CodeForAfrica/sensors.AFRICA-AQ-sensors-hardware-GSM/src/AQ_sensor_GSM.brd

## EAGLE design src/AQ_sensor_GSM.brd (2023-09-25)

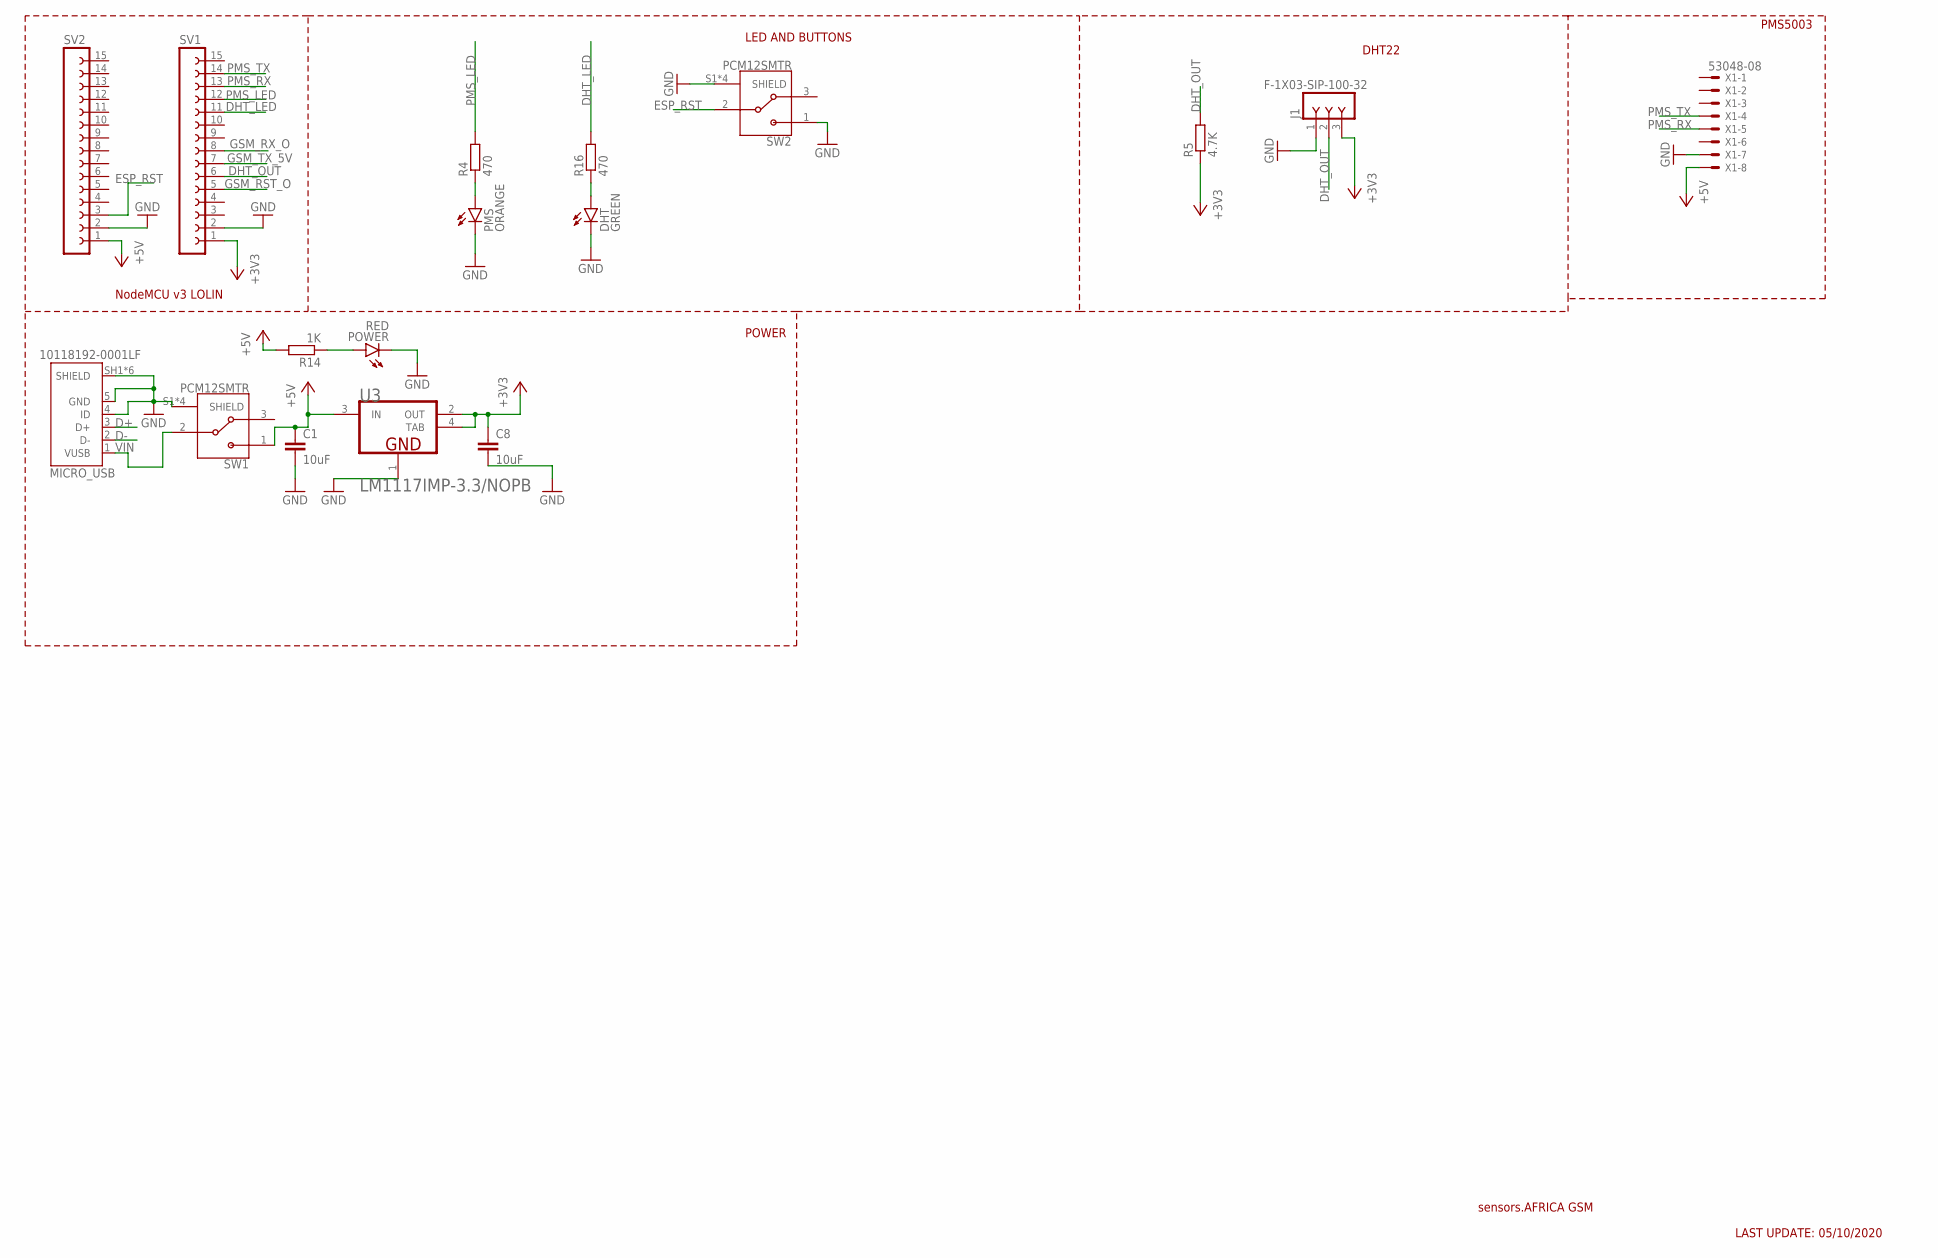
[picture p1: schematic AQ_sensor_GSM.sch, sheet 1]

Parts:
C1, C8: 10uF; C0603
DHT: GREEN; CHIP-LED0603
J1: F-1X03-SIP-100-32; SIP-100-03-32
MICRO_USB: 10118192-0001LF; AMPHENOL_10118192-0001LF
PMS: ORANGE; CHIP-LED0603
POWER: RED; CHIP-LED0603
R4, R16: 470; R0603
R5: 4.7K; R0603
R14: 1K; R0603
SV1, SV2: FE15-1; FE15
SW1, SW2: PCM12SMTR; SW_PCM12SMTR
U3: TEXAS_INSTRUMENTS_LM1117IMP-3.3-NOPBTEXAS_INSTRUM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; TEXAS_INSTRUMENTS_LM1117IMP-3.3-NOPB_0
X1: 53048-08

Connections:
+3V3: C8.1, J1.3, R5.1, SV1.1, U3.2 (OUT), U3.4 (TAB)
+5V: C1.1, R14.2, SV2.1, SW1.1, U3.3 (IN), X1.8; also elsewhere on the board
D+: MICRO_USB.3 (D+)
D-: MICRO_USB.2 (D-)
DHT_LED: R16.2, SV1.11
DHT_OUT: J1.2, R5.2, SV1.6
ESP_RST: SV2.3, SW2.2
GND: C1.2, C8.2, DHT.C, J1.1, MICRO_USB.4 (ID), MICRO_USB.5 (GND), MICRO_USB.SH1 (SHIELD), MICRO_USB.SH2 (SHIELD), MICRO_USB.SH3 (SHIELD), MICRO_USB.SH4 (SHIELD), MICRO_USB.SH5 (SHIELD), MICRO_USB.SH6 (SHIELD), PMS.C, POWER.C, SV1.2, SV2.2, SW1.S1 (SHIELD), SW1.S2 (SHIELD), SW1.S3 (SHIELD), SW1.S4 (SHIELD), SW2.1, SW2.S1 (SHIELD), SW2.S2 (SHIELD), SW2.S3 (SHIELD), SW2.S4 (SHIELD), U3.1 (GND), X1.7; also elsewhere on the board
GSM_RST_O: SV1.5
GSM_RX_O: SV1.8; also elsewhere on the board
GSM_TX_5V: SV1.7; also elsewhere on the board
unnamed: PMS.A, R4.1
unnamed: POWER.A, R14.1
unnamed: DHT.A, R16.1
PMS_LED: R4.2, SV1.12
PMS_RX: SV1.13, X1.5
PMS_TX: SV1.14, X1.4
VIN: MICRO_USB.1 (VUSB), SW1.2

Notes on the sheet:
sensors.AFRICA GSM
LAST UPDATE: 05/10/2020
LED AND BUTTONS
PMS5003
DHT22
NodeMCU v3 LOLIN
POWER

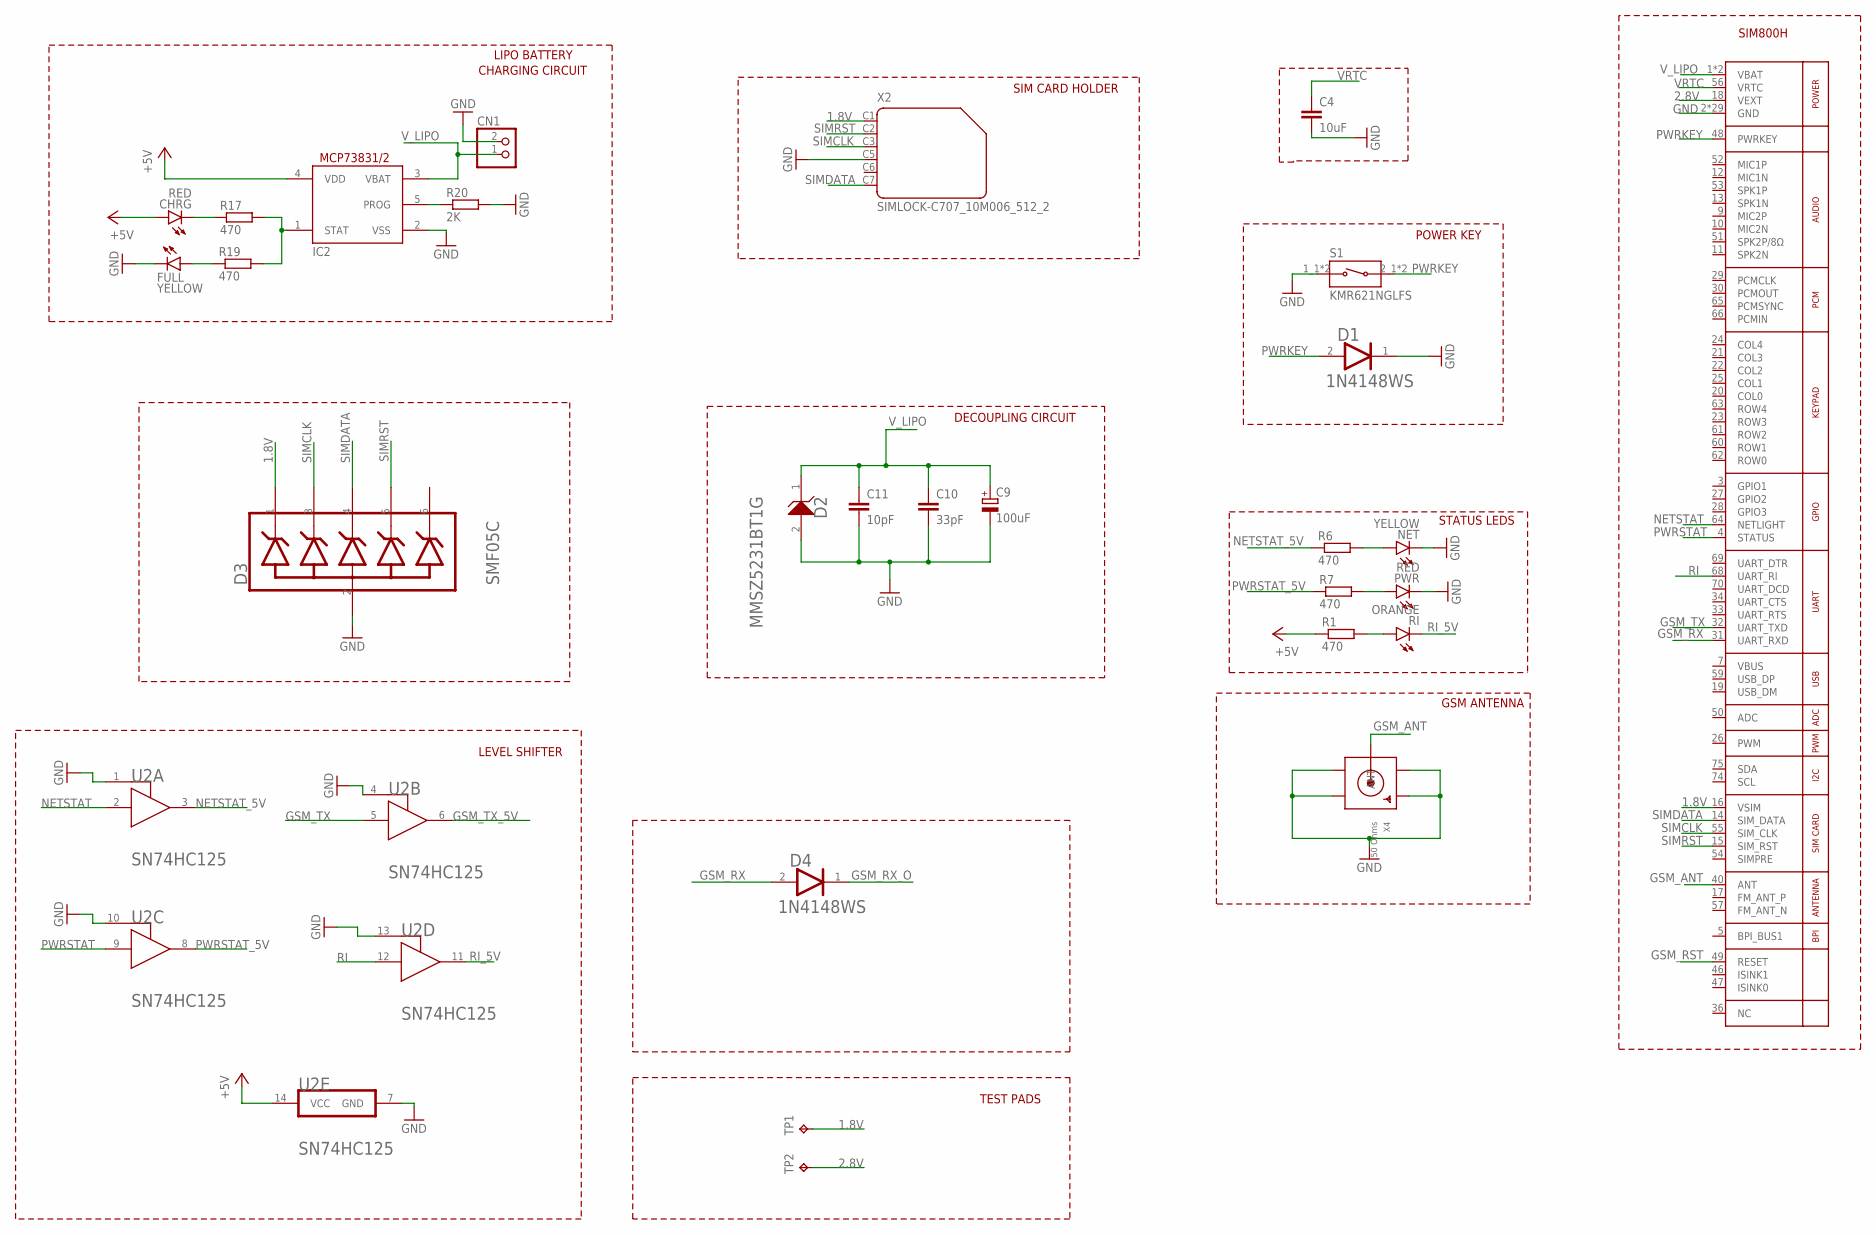
[picture p2: schematic AQ_sensor_GSM.sch, sheet 2]

Parts:
C4: 10uF; C0603
C9: 100uF; PANASONIC_D
C10: 33pF; C0603
C11: 10pF; C0603
CHRG: RED; CHIP-LED0603
CN1: JST_2PIN-SMT-RA; JST-PH-2-SMT-RA
D1, D4: ON_SEMI_1N4148WSON_SEMI_1N4148WS_0_0; ON_SEMI_1N4148WS_0
D2: ON_SEMICONDUCTOR_MMSZ5231BT1GON_SEMICONDUCTOR_MMS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; ON_SEMICONDUCTOR_MMSZ5231BT1G_0
D3: SEMTECH_SMF05CSEMTECH_SMF05C_0_0; SEMTECH_SMF05C_0
FULL: YELLOW; CHIP-LED0603
IC2: MCP73831/OT; SOT23-5L
NET: YELLOW; CHIP-LED0603
PWR: RED; CHIP-LED0603
R1, R6, R7, R17, R19: 470; R0603
R20: 2K; R0603
RI: ORANGE; CHIP-LED0603
S1: KMR621NGLFS; SW_KMR621NGLFS
TP1, TP2: TPB1,27; B1,27
U1: GSM_SIM800L; SIM800L
U2: TEXAS_INSTRUMENTS_SN74HC125TEXAS_INSTRUMENTS_SN74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; TEXAS_INSTRUMENTS_SN74HC125_0
X2: SIMLOCK-C707_10M006_512_2; C707_10M006_512_2
X4: 50 Ohms; SMA_EDGELAUNCH_UFL

Connections:
1.8V: D3.1 (1_CATHODE), TP1.TP, U1.16 (VSIM), X2.C1 (1)
2.8V: TP2.TP, U1.18 (VEXT)
+5V: CHRG.A, IC2.4 (VDD), R1.1, U2.14 (VCC); also elsewhere on the board
GND: C4.2, C9.-, C10.2, C11.2, CN1.2 (1), D1.1 (CATHODE), D2.2 (A), D3.2 (ANODE), FULL.C, IC2.2 (VSS), NET.C, PWR.C, R20.2, S1.1_1 (1), S1.1_2 (1), U1.2 (GND), U1.6 (GND), U1.8 (GND), U1.35 (GND), U1.37 (GND), U1.38 (GND), U1.39 (GND), U1.41 (GND), U1.43 (GND), U1.44 (GND), U1.45 (GND), U1.58 (GND), U1.67 (GND), U1.71 (GND), U1.72 (GND), U1.73 (GND), U1.76 (GND), U1.77 (GND), U1.78 (GND), U1.79 (GND), U1.80 (GND), U1.81 (GND), U1.82 (GND), U1.83 (GND), U1.84 (GND), U1.85 (GND), U1.86 (GND), U1.87 (GND), U1.88 (GND), U2.1 (1_!OE!), U2.4 (4_!OE!), U2.7 (GND), U2.10 (2_!OE!), U2.13 (3_!OE!), X2.C5 (4), X4.GND@1 (GND1), X4.GND@2 (GND2), X4.GND@3 (GND3), X4.GND@4 (GND4); also elsewhere on the board
GSM_ANT: U1.40 (ANT), X4.P (ANT)
GSM_RST: U1.49 (RESET)
GSM_RX: D4.2 (ANODE), U1.31 (UART_RXD)
GSM_RX_O: D4.1 (CATHODE); also elsewhere on the board
GSM_TX: U1.32 (UART_TXD), U2.5 (2A)
GSM_TX_5V: U2.6 (2Y); also elsewhere on the board
unnamed: CHRG.C, R17.1
unnamed: IC2.1 (STAT), R17.2, R19.2
unnamed: NET.A, R6.2
unnamed: PWR.A, R7.2
unnamed: FULL.A, R19.1
unnamed: IC2.5 (PROG), R20.1
unnamed: R1.2, RI.A
NETSTAT: U1.64 (NETLIGHT), U2.2 (1A)
NETSTAT_5V: R6.1, U2.3 (1Y)
PWRKEY: D1.2 (ANODE), S1.2_1 (2), S1.2_2 (2), U1.48 (PWRKEY)
PWRSTAT: U1.4 (STATUS), U2.9 (3A)
PWRSTAT_5V: R7.1, U2.8 (3Y)
RI: U1.68 (UART_RI), U2.12 (4A)
RI_5V: RI.C, U2.11 (4Y)
SIMCLK: D3.3 (2_CATHODE), U1.55 (SIM_CLK), X2.C3 (3)
SIMDATA: D3.4 (3_CATHODE), U1.14 (SIM_DATA), X2.C7 (6)
SIMRST: D3.5 (4_CATHODE), U1.15 (SIM_RST), X2.C2 (2)
VBUS: U1.7 (VBUS)
VRTC: C4.1, U1.56 (VRTC)
V_LIPO: C9.+, C10.1, C11.1, CN1.1 (2), D2.1 (K), IC2.3 (VBAT), U1.1 (VBAT), U1.42 (VBAT)

Notes on the sheet:
SIM800H
POWER KEY
STATUS LEDS
SIM CARD HOLDER
CHARGING CIRCUIT
LIPO BATTERY
GSM ANTENNA
TEST PADS
LEVEL SHIFTER
DECOUPLING CIRCUIT

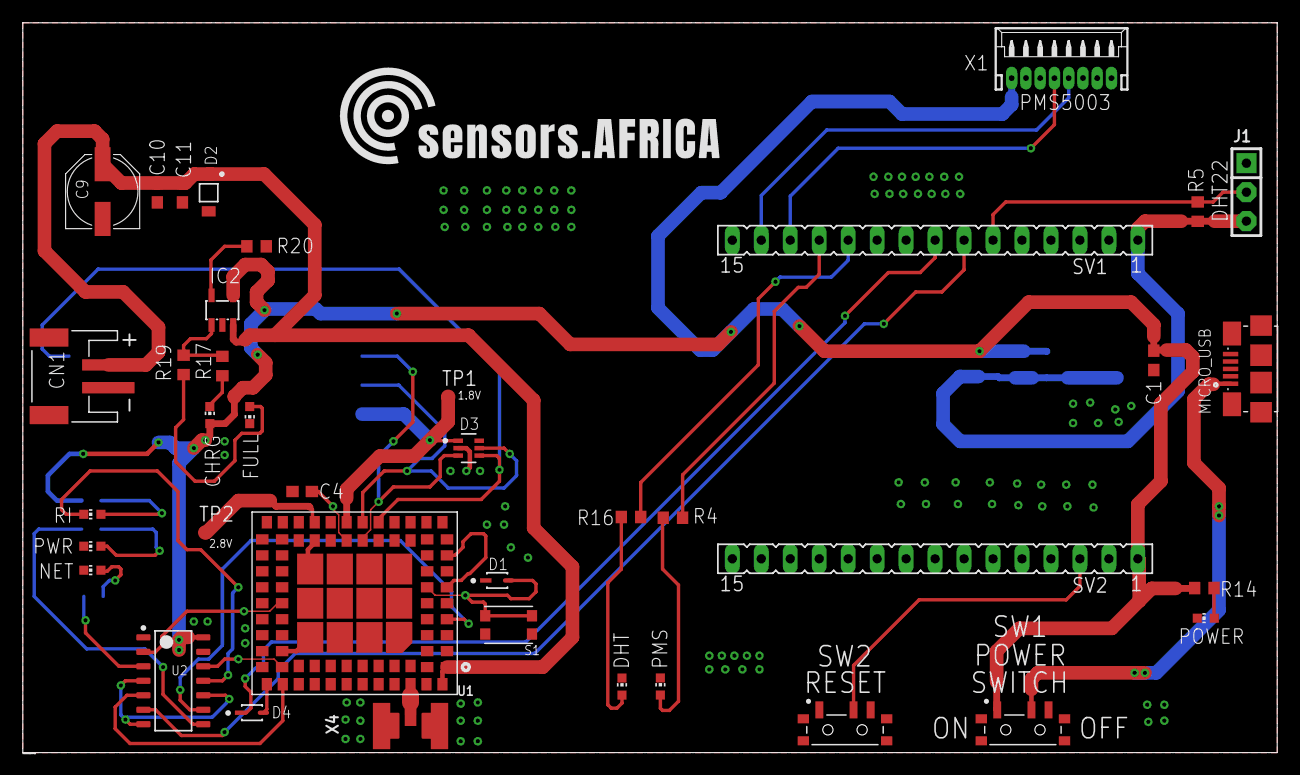
[picture p3: board AQ_sensor_GSM.brd from above]

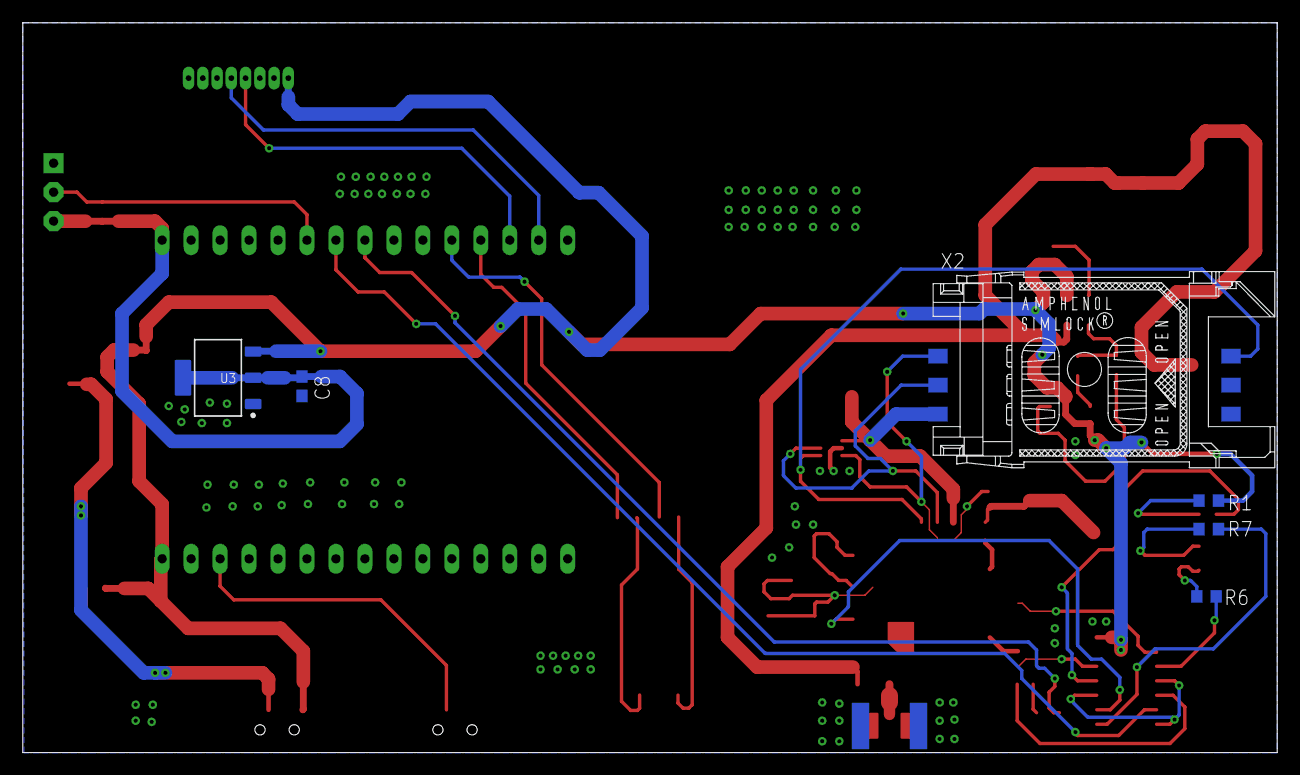
[picture p4: board AQ_sensor_GSM.brd from below]

Board: 2 copper layers, 110.0 x 64.0 mm, 45 parts (6 on the bottom side), 39 nets.
