CodeForAfrica/sensors.AFRICA-AQ-sensors-hardware-GSM/(threads)

Thread 2 (2023-09-13):

Compare main branch with fix/swap-dht-pms-locations branch

gideonmaina, 2023-09-13:
[REF ORDER](https://circuithub.com/project-orders/sensors.AFRICA/000ea94e)
fix/swap-dht-pms-locations branch was used for the first version of the AQ enclosure.

augustinemwendwa72, 2023-09-15:
[Comparison between main and fix/swap-dht-pms-locations github branches](https://github.com/CodeForAfrica/sensors.AFRICA-AQ-sensors-hardware-GSM/issues/2)

The Following are the findings on reviewing the designs contained in the above mentioned GitHub branches:

- The two branches contain similar files, similar design schematics and PCB designs. The images attached show these similarities.
- Both designs were not used to print currently used AQ sensor boards, since all do have mounting holes on the PCB unlike the designs in these git  branches.

**feature/generate_manufacturing_files**
PCB Layout
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
**Top View**
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
**Bottom View**
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

Git Branch Branch: [main](url)
**PCB Layout**
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

Top View
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

Bottom View
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

gideonmaina, 2023-09-15:
@augustinemwendwa72 reminder that the branch of interest is **fix/swap-dht-pms-locations-branch**.  Changing the title of the issue is misleading as it is not what this issue is about.

P.S. There was already a [PR on **feature/generate_manufacturing_files**](https://github.com/CodeForAfrica/sensors.AFRICA-AQ-sensors-hardware-GSM/pull/1) branch and was subsequently deleted.

gideonmaina, 2023-09-15:
I will restore the title @augustinemwendwa72 . You can delete the comment associated with the generate_manufacturing_files branch and proceed with this issue's topic.

augustinemwendwa72, 2023-09-19:
[Comparison between main and fix/swap-dht-pms-locations github branches](https://github.com/CodeForAfrica/sensors.AFRICA-AQ-sensors-hardware-GSM/issues/2)

The Following are the findings on reviewing the designs contained in the above mentioned GitHub branches:

- The fix/swap-dht-pms-locations branch is the updated version of the main branch.
- The PCB layout on the main branch does not have mounting holes.
- The PCB layout on the fix/swap-dht-pms-locations branch has mounting holes.
- The PCB files sent to [www.circuithub.com](https://circuithub-static1.s3.amazonaws.com/orders/11245/attachments/LTximzySSLej1t2K4i03_Image%20from%20iOS%28861%29.jpg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) for manufacturing match those on the fix/swap-dht-pms-locations.
- I suggest a merge with the main, considering fix/swap-dht-pms-locations is the most updated version of the main branch.

**AQ Board sent to [www.circuithub.com](https://circuithub-static1.s3.amazonaws.com/orders/11245/attachments/LTximzySSLej1t2K4i03_Image%20from%20iOS%28861%29.jpg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)**
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

**Git Branch: [fix/swap-dht-pms-locations](https://github.com/CodeForAfrica/sensors.AFRICA-AQ-sensors-hardware-GSM.git)**
PCB Layout (fix/swap-dht-pms-locations)
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
**Top View (fix/swap-dht-pms-locations)**
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
**Bottom View (fix/swap-dht-pms-locations)**
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

Git Branch: [main](https://github.com/CodeForAfrica/sensors.AFRICA-AQ-sensors-hardware-GSM.git)
**PCB Layout (main)**
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

Top View (main)
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

Bottom View (main)
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

Closed 2023-09-20.

Thread 5 (2024-08-29):

Board versioning

gideonmaina, 2024-08-29:
Let us come up with a list of naming conventions for our board. *_Not limited to GSM enabled boards _*.
@augustinemwendwa72 @usmanbiu . We can move this to discussions.

augustinemwendwa72, 2024-08-30:
@gideonmaina @usmanbiu We can come up with a uniform convention for naming both hardware and software versions. Also, a readme file or any form of document

For the versioning, we can have:

- MCU Board type (eg, E32 for ESP32)
- Version year and month (eg, 0824)
- Group (H, S, or E) for Hardware, Software or Enclosure.
- No need to include all the details, the aim is to have a Unique version. An example name would look like E320824H. E320824H and E320824S should be Compatible.

We can even have Nicknames for each version, something easily memorable.

usmanbiu, 2024-08-30:
@augustinemwendwa72 this makes a lot of sense. We should add a tag to let us know the boards with a simcom or quecktel chip. I recommend we add "(S)" at the end of the names of the boards with the simcom chip e.g E820819(S), while leaving the ones with a quecktel chip with no tag. This is because we only have one version of the board with a simcom chip while we are already working on the third version with a quecktel chip.

I also think it would be a good idea to give the nicknames for ease of use during conversations e.g kawari, yula etc

cc @gideonmaina

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

Thread 9 (2025-02-24):

Correct PIN labels (Quectel board v112024)

gideonmaina, 2025-02-24:
Pin labels should match the convention of pin definitions on the firmware side.

Pin labels that need changing:
1. PMS
- RX = GPIO 21
- TX = GPIO 45

2. SD
MISO and MOSI need to be swapped

augustinemwendwa72, 2025-02-24:
Hey, @gideonmaina , Noted, I am considering this update on our next PCB iteration. Please let me know if there is any other pin that needs attention (Lora, Gsm or such).

Closed 2025-03-13.
